ctraabe/BLCtrlToPPM/README.md

# BLCtrlToPWM
University of Tokyo custom board to convert Mikrokopter BLCtrl Commands to typical PWM ESC commands based on ATMega2560
