ctraabe/BLCtrlToPPM/Hardware/BLCtrlToPWM_DigiKey_BOM.xls

Digi-Key品番 | 仕入先 | メーカー品番 | 客先参照品番（任意） | 数量 1 | 数量 2 | 数量 3 | メーカー標準リードタイム | 商品概要 | 注記事項 | RoHS ステータス | 鉛フリーステータス | REACHステータス
S1011EC-40-ND | SULLINS CONNECTOR SOLUTIONS | PRPC040SAAN-RC |  | 1 | 0 | 0 | 3 週間 | CONN HEADER .100" SNGL STR 40POS |  | RoHS対応 | 鉛フリー | 影響なし 6-2016
S2011EC-20-ND | SULLINS CONNECTOR SOLUTIONS (VA) | PRPC020DAAN-RC |  | 1 | 0 | 0 | 4 週間 | CONN HEADER .100" DUAL STR 40POS | 出荷予定日は、未定です。 | RoHS対応 | 鉛フリー | 影響なし 6-2016
ATMEGA2560-16AU-ND | MICROCHIP TECHNOLOGY | ATMEGA2560-16AU | IC1 | 1 | 0 | 0 | 10 週間 | IC MCU 8BIT 256KB FLASH 100TQFP | 他の梱包形態が存在します。 | RoHS対応 | 鉛フリー | 影響なし 12-2015
1276-2605-1-ND | SAMSUNG ELECTRO-MECHANICS AMERICA, INC (VA) | CL21C220JB61PNC | C1,C2 | 2 | 0 | 0 | 17 週間 | CAP CER 22PF 50V NP0 0805 | 他の梱包形態が存在します。 | RoHS対応 | 鉛フリー | 影響なし 6-2016
1276-1090-1-ND | SAMSUNG ELECTRO-MECHANICS AMERICA, INC (VA) | CL21B104JBCNNNC | C3,C4,C5,C6 | 4 | 0 | 0 | 13 週間 | CAP CER 0.1UF 50V X7R 0805 | 他の梱包形態が存在します。 | RoHS対応 | 鉛フリー | 影響なし 6-2016
399-3684-1-ND | KEMET (VA) | T491A106K010AT | C7 | 1 | 0 | 0 | 4 週間 | CAP TANT 10UF 10V 10% 1206 |  | RoHS対応 | 鉛フリー | 影響なし 6-2016
475-1410-1-ND | OSRAM OPTO SEMICONDUCTORS INC(VA) | LG R971-KN-1 | D4 | 1 | 0 | 0 | 8 週間 | LED GREEN DIFFUSED 0805 SMD | 他の梱包形態が存在します。 | RoHS対応 | 鉛フリー | 影響なし 12-2015
475-2560-1-ND | OSRAM OPTO SEMICONDUCTORS INC(VA) | LY R976-PS-36 | D1,D5 | 2 | 0 | 0 | 8 週間 | LED YELLOW DIFFUSED 0805 SMD | 他の梱包形態が存在します。 | RoHS対応 | 鉛フリー | 影響なし 12-2015
475-1415-1-ND | OSRAM OPTO SEMICONDUCTORS INC(VA) | LH R974-LP-1 | D3 | 1 | 0 | 0 | 14 週間 | LED RED DIFFUSED 0805 SMD | 他の梱包形態が存在します。 | RoHS対応 | 鉛フリー | 影響なし 12-2015
732-4982-1-ND | WURTH ELECTRONICS INC (VA) | 150080BS75000 | D2,D6 | 2 | 0 | 0 | 10 週間 | LED BLUE CLEAR 0805 SMD | 他の梱包形態が存在します。 | RoHS対応 | 鉛フリー | 影響なし 6-2016
P10.0KCCT-ND | PANASONIC ELECTRONIC COMPONENTS (VA) | ERJ-6ENF1002V | R1,R9,R10 | 3 | 0 | 0 | 6 週間 | RES SMD 10K OHM 1% 1/8W 0805 | 他の梱包形態が存在します。 | RoHS対応 | 鉛フリー | 影響なし 6-2015
P2.20KCCT-ND | PANASONIC ELECTRONIC COMPONENTS (VA) | ERJ-6ENF2201V | R2,R3,R5,R6 | 4 | 0 | 0 | 6 週間 | RES SMD 2.2K OHM 1% 1/8W 0805 | 他の梱包形態が存在します。 | RoHS対応 | 鉛フリー | 影響なし 6-2015
P1.00KCCT-ND | PANASONIC ELECTRONIC COMPONENTS (VA) | ERJ-6ENF1001V | R4,R7 | 2 | 0 | 0 | 6 週間 | RES SMD 1K OHM 1% 1/8W 0805 | 他の梱包形態が存在します。 | RoHS対応 | 鉛フリー | 影響なし 6-2015
P10849SCT-ND | PANASONIC ELECTRONIC COMPONENTS (VA) | EVQ-PUC02K | SW1 | 1 | 0 | 0 | 6 週間 | SWITCH TACTILE SPST-NO 0.05A 12V | 他の梱包形態が存在します。 | RoHS対応 | 鉛フリー | 影響なし 6-2015
887-1244-ND | TXC CORPORATION | 9B-16.000MEEJ-B | Y1 | 1 | 0 | 0 | 13 週間 | CRYSTAL 16.0000MHZ 18PF T/H |  | RoHS対応 | 鉛フリー | 影響なし 12-2015
BSS138CT-ND | FAIRCHILD SEMICONDUCTOR (VA) | BSS138 | Q1,Q2,Q3,Q4,Q5 | 5 | 0 | 0 | 8 週間 | MOSFET N-CH 50V 220MA SOT-23 | 他の梱包形態が存在します。 | RoHS対応 | 鉛フリー | 影響なし 6-2016
P1.00MCCT-ND | PANASONIC ELECTRONIC COMPONENTS (VA) | ERJ-6ENF1004V | R8 | 1 | 0 | 0 | 6 週間 | RES SMD 1M OHM 1% 1/8W 0805 | 他の梱包形態が存在します。 | RoHS対応 | 鉛フリー | 影響なし 6-2015
