ctraabe/BLCtrlToPPM/Hardware/BLCtrlToPWM.kicad_pcb

## KiCad design Hardware/BLCtrlToPWM.kicad_pcb (2017-01-05)

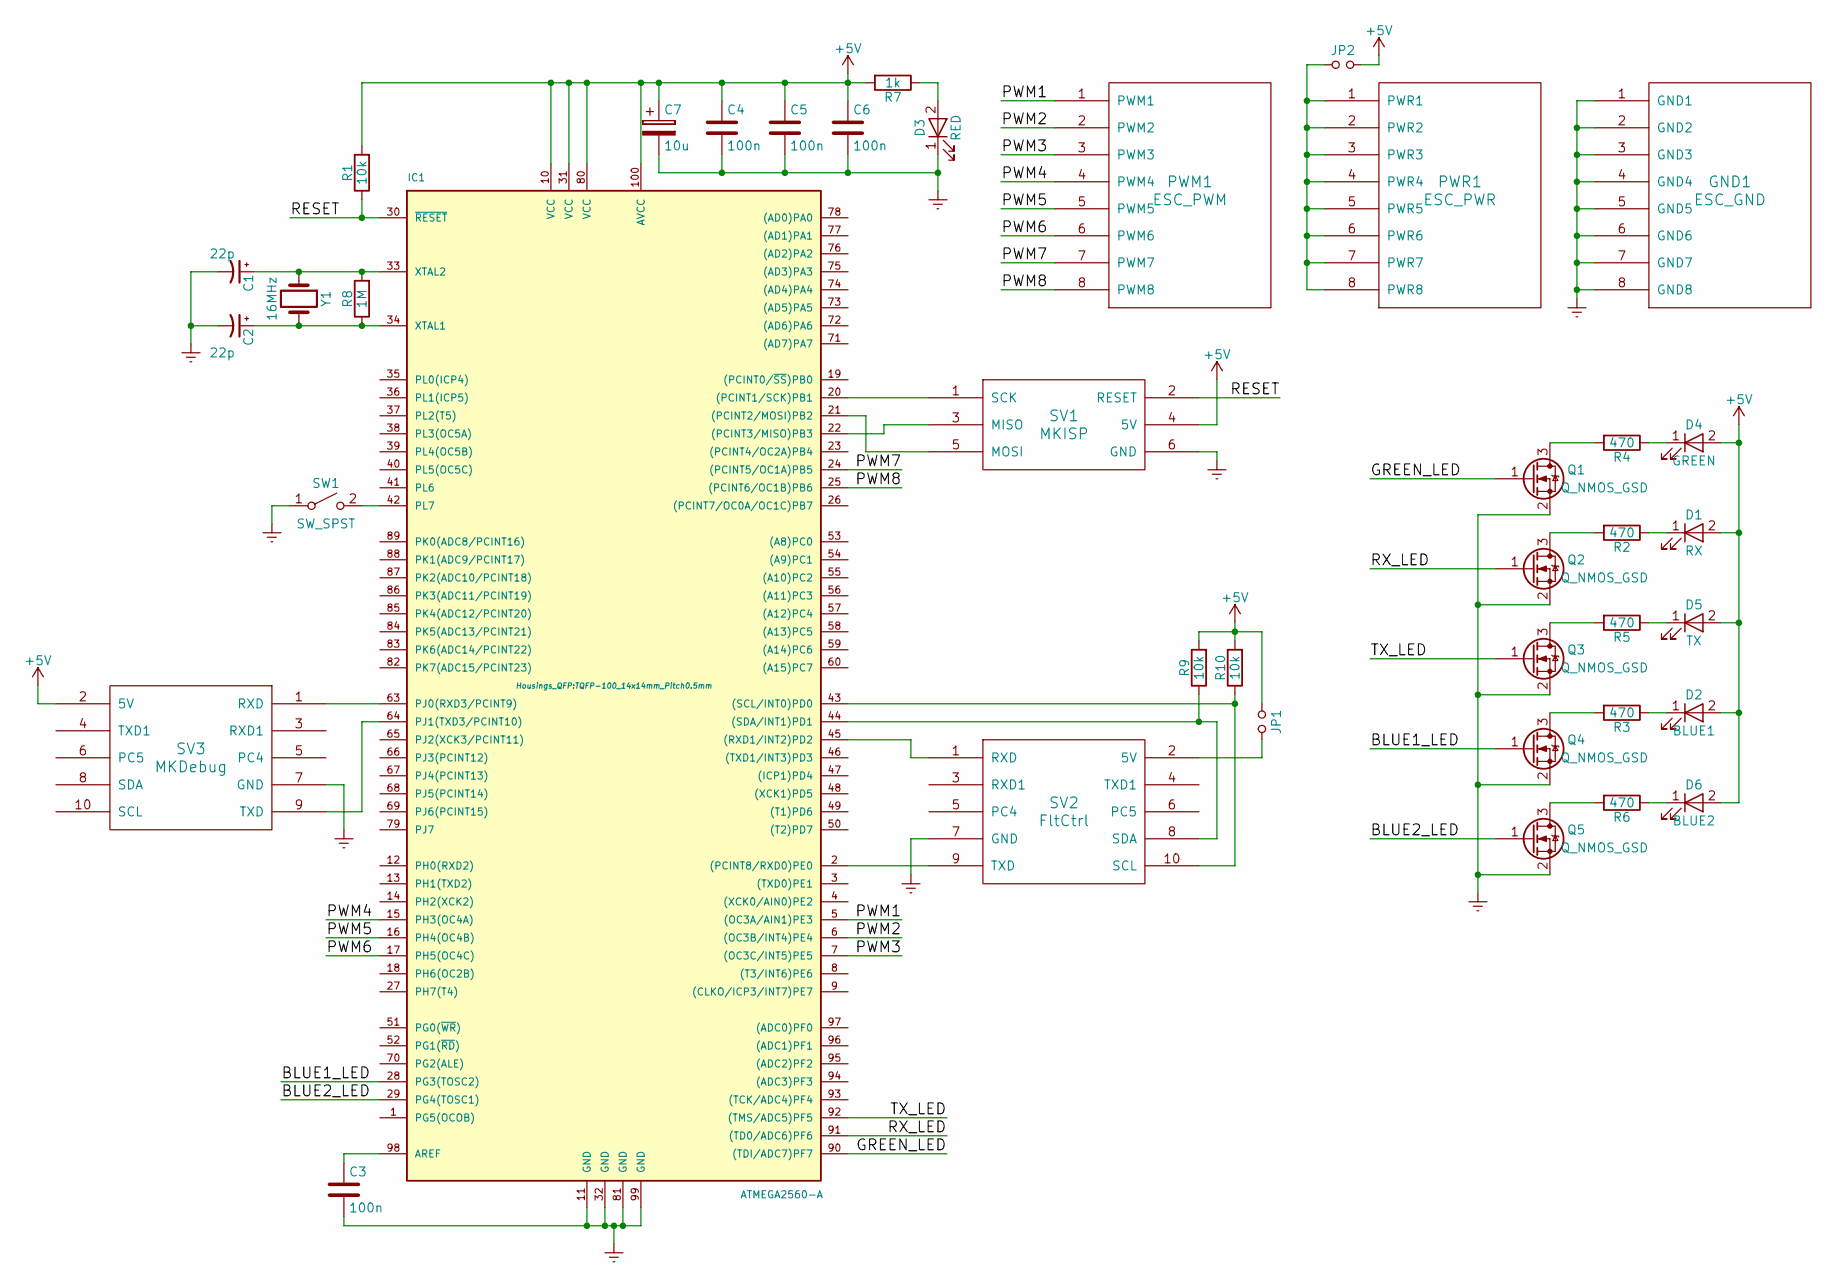
[picture p1: schematic BLCtrlToPWM.sch, BLCtrl Command to PWM Converter]

Parts:
C1, C2: 22p; C_0805_HandSoldering
C3, C4, C5, C6: 100n; C_0805_HandSoldering
C7: 10u; C_1210_HandSoldering
D1: RX; LED-0805
D2: BLUE1; LED-0805
D3: RED; LED-0805
D4: GREEN; LED-0805
D5: TX; LED-0805
D6: BLUE2; LED-0805
GND1: ESC_GND; Pin_Header_Straight_1x08
IC1: ATMEGA2560-A; TQFP-100_14x14mm_Pitch0.5mm
JP1, JP2: Jumper_NO_Small; Pin_Header_Straight_1x02
PWM1: ESC_PWM; Pin_Header_Straight_1x08
PWR1: ESC_PWR; Pin_Header_Straight_1x08
Q1, Q2, Q3, Q4, Q5: Q_NMOS_GSD; SOT-23_Handsoldering
R1, R9, R10: 10k; R_0805_HandSoldering
R2, R3, R4, R5, R6: 470; R_0805_HandSoldering
R7: 1k; R_0805_HandSoldering
R8: 1M; R_0805_HandSoldering
SV1: MKISP; Pin_Header_Edge_2x03
SV2: FltCtrl; Pin_Header_Edge_2x05
SV3: MKDebug; Pin_Header_Edge_2x05
SW1: SW_SPST; PanasonicEVQPU_SPST_NO
Y1: 16MHz; Crystal_HC49-U_Vertical

Connections:
+5V: C4.1, C5.1, C6.1, C7.1, D1.2 (A), D2.2 (A), D4.2 (A), D5.2 (A), D6.2 (A), IC1.10 (VCC), IC1.31 (VCC), IC1.80 (VCC), IC1.100 (AVCC), JP1.1, JP2.2, R1.2, R7.2, R9.2, R10.2, SV1.4 (5V), SV3.2 (5V)
/BLUE1_LED: IC1.28 (PG3(TOSC2)), Q4.1 (G)
/BLUE2_LED: IC1.29 (PG4(TOSC1)), Q5.1 (G)
/GREEN_LED: IC1.90 ((TDI/ADC7)PF7), Q1.1 (G)
/PWM1: IC1.5 ((OC3A/AIN1)PE3), PWM1.1 (PWM1)
/PWM2: IC1.6 ((OC3B/INT4)PE4), PWM1.2 (PWM2)
/PWM3: IC1.7 ((OC3C/INT5)PE5), PWM1.3 (PWM3)
/PWM4: IC1.15 (PH3(OC4A)), PWM1.4 (PWM4)
/PWM5: IC1.16 (PH4(OC4B)), PWM1.5 (PWM5)
/PWM6: IC1.17 (PH5(OC4C)), PWM1.6 (PWM6)
/PWM7: IC1.24 ((PCINT5/OC1A)PB5), PWM1.7 (PWM7)
/PWM8: IC1.25 ((PCINT6/OC1B)PB6), PWM1.8 (PWM8)
/RESET: IC1.30 (~RESET), R1.1, SV1.2 (RESET)
/RX_LED: IC1.91 ((TD0/ADC6)PF6), Q2.1 (G)
/TX_LED: IC1.92 ((TMS/ADC5)PF5), Q3.1 (G)
Earth: C1.2, C2.2, C3.2, C4.2, C5.2, C6.2, C7.2, D3.1 (K), GND1.1 (GND1), GND1.2 (GND2), GND1.3 (GND3), GND1.4 (GND4), GND1.5 (GND5), GND1.6 (GND6), GND1.7 (GND7), GND1.8 (GND8), IC1.11 (GND), IC1.32 (GND), IC1.81 (GND), IC1.99 (GND), Q1.2 (S), Q2.2 (S), Q3.2 (S), Q4.2 (S), Q5.2 (S), SV1.6 (GND), SV2.7 (GND), SV3.7 (GND), SW1.1 (A)
unnamed: C1.1, IC1.33 (XTAL2), R8.2, Y1.1
unnamed: C2.1, IC1.34 (XTAL1), R8.1, Y1.2
unnamed: C3.1, IC1.98 (AREF)
unnamed: D1.1 (K), R2.1
unnamed: D2.1 (K), R3.1
unnamed: D3.2 (A), R7.1
unnamed: D4.1 (K), R4.1
unnamed: D5.1 (K), R5.1
unnamed: D6.1 (K), R6.1
unnamed: IC1.2 ((PCINT8/RXD0)PE0), SV2.9 (TXD)
unnamed: IC1.20 ((PCINT1/SCK)PB1), SV1.1 (SCK)
unnamed: IC1.21 ((PCINT2/MOSI)PB2), SV1.5 (MOSI)
unnamed: IC1.22 ((PCINT3/MISO)PB3), SV1.3 (MISO)
unnamed: IC1.42 (PL7), SW1.2 (B)
unnamed: IC1.43 ((SCL/INT0)PD0), R10.1, SV2.10 (SCL)
unnamed: IC1.44 ((SDA/INT1)PD1), R9.1, SV2.8 (SDA)
unnamed: IC1.45 ((RXD1/INT2)PD2), SV2.1 (RXD)
unnamed: IC1.63 (PJ0(RXD3/PCINT9)), SV3.1 (RXD)
unnamed: IC1.64 (PJ1(TXD3/PCINT10)), SV3.9 (TXD)
unnamed: JP1.2, SV2.2 (5V)
unnamed: JP2.1, PWR1.1 (PWR1), PWR1.2 (PWR2), PWR1.3 (PWR3), PWR1.4 (PWR4), PWR1.5 (PWR5), PWR1.6 (PWR6), PWR1.7 (PWR7), PWR1.8 (PWR8)
unnamed: Q1.3 (D), R4.2
unnamed: Q2.3 (D), R2.2
unnamed: Q3.3 (D), R5.2
unnamed: Q4.3 (D), R3.2
unnamed: Q5.3 (D), R6.2

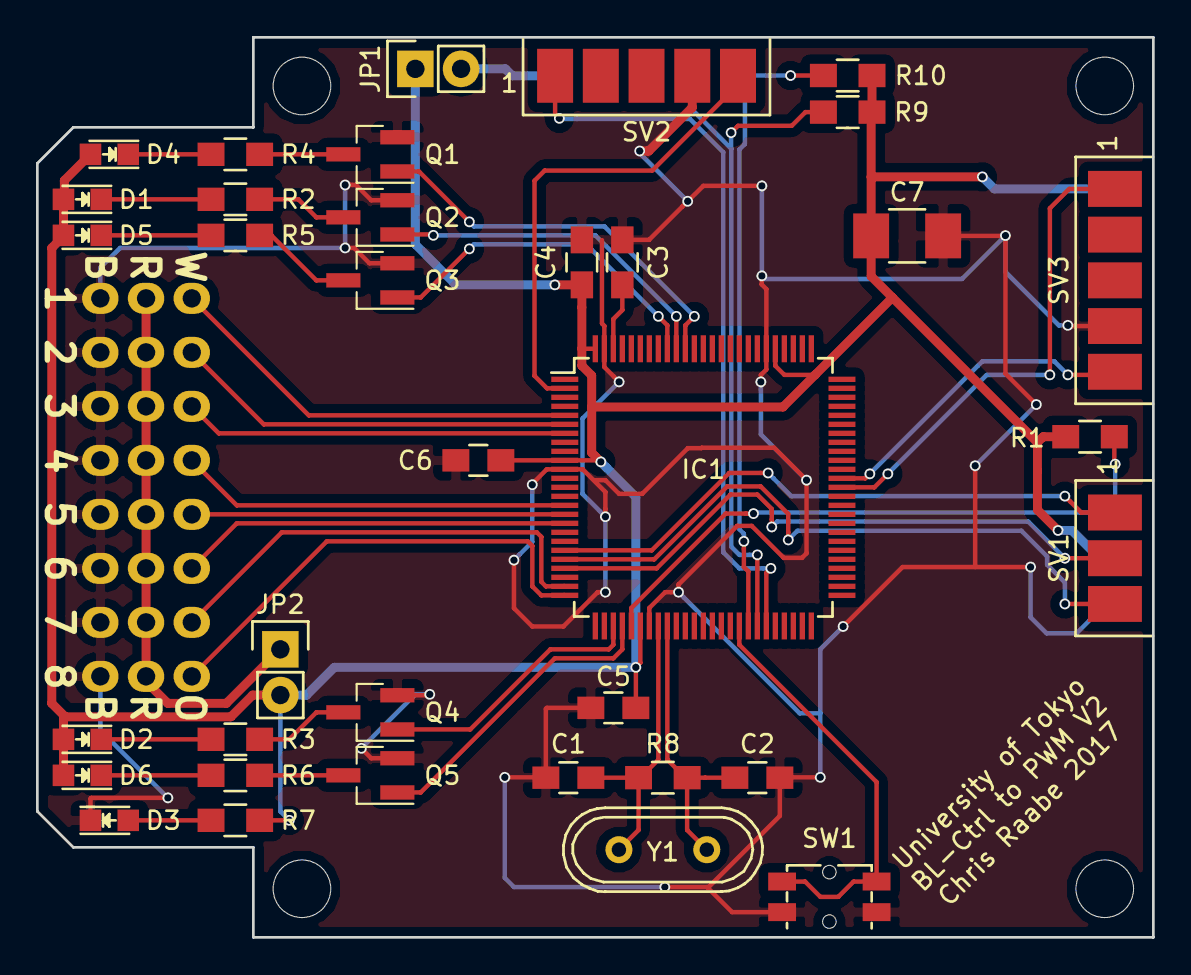
[picture p2: board BLCtrlToPWM.kicad_pcb from above]

Board: 2 copper layers, 62.0 x 50.0 mm, 39 parts (0 on the bottom side), 42 nets.
