ctraabe/BLCtrlToPPM/led.h

#ifndef LED_H_
#define LED_H_


// =============================================================================
// Public functions:

void LEDInit(void);

// -----------------------------------------------------------------------------
void BlueLED1Off(void);

// -----------------------------------------------------------------------------
void BlueLED1On(void);

// -----------------------------------------------------------------------------
void BlueLED1Toggle(void);

// -----------------------------------------------------------------------------
void BlueLED2Off(void);

// -----------------------------------------------------------------------------
void BlueLED2On(void);

// -----------------------------------------------------------------------------
void BlueLED2Toggle(void);

// -----------------------------------------------------------------------------
void GreenLEDOff(void);

// -----------------------------------------------------------------------------
void GreenLEDOn(void);

// -----------------------------------------------------------------------------
void GreenLEDToggle(void);

// -----------------------------------------------------------------------------
void YellowLED1Off(void);

// -----------------------------------------------------------------------------
void YellowLED1On(void);

// -----------------------------------------------------------------------------
void YellowLED1Toggle(void);

// -----------------------------------------------------------------------------
void YellowLED2Off(void);

// -----------------------------------------------------------------------------
void YellowLED2On(void);

// -----------------------------------------------------------------------------
void YellowLED2Toggle(void);


#endif  // LED_H_
