ctraabe/BLCtrlToPPM/(commit log)

2015-10-30 Modified the handling of Arduino pins
2015-10-30 Added framework for PWM output. TODO: Add functions to change pulse widths from 1.1 ms to 1.94 ms.
2015-11-02 Added framework for setting individual PPM channels from 0 to 1680 (TIMER4 only)
2015-11-06 Updated arduino header to allow setting of pin modes.
2015-11-06 Added uart
2015-11-08 First attempt at adding BLCtrl command reception. Should probably just put all i2c AND blctrl protocol stuff in the same file since it won't be doing anything else.
    [i2c.c, i2c.h, main.c]
2015-11-16 Adapted code to new custom board. It works!
2016-02-03 Fixed i2c addressing error
    [i2c.c, ppm.c]
2016-02-03 Removed UART due to interference with other comms (need to be fixed in next board revision)
    [main.c]
2016-11-17 Changed mistaken references to PPM to PWM (non-functional change)
    [main.c, pwm.c, pwm.h]
2016-11-17 Added board design files to the repository
    [BLCtrlToPWM-B_Cu.gbr, BLCtrlToPWM-B_Mask.gbr, BLCtrlToPWM-B_SilkS.gbr, BLCtrlToPWM-Edge_Cuts.gbr, BLCtrlToPWM-F_Cu.gbr, BLCtrlToPWM-F_Mask.gbr, BLCtrlToPWM-F_SilkS.gbr, BLCtrlToPWM-NPTH.drl]
2016-11-17 Added MikroKopter KiCad library as a submodule
2016-12-15 Added second debug serial output. Changed TX on existing serial linesto RX. Added N-MOSFETs to LEDs to remove current requrements on MCU. Added jumpers for power source selection (preferably use the 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
    [BLCtrlToPWM.sch]
2016-12-17 Added common KiCad library
2016-12-17 Updated KiCadCommon submodule (with corrected edge pin header solder mask layers)
2016-12-17 Updated board layout with new components, but they are yet to be placed and traces need to be added
    [BLCtrlToPWM.kicad_pcb]
2016-12-17 Updated gerber files to match new KiCad standard naming convention
    [BLCtrlToPWM-B.Cu.gbr, BLCtrlToPWM-B.Mask.gbr, BLCtrlToPWM-B.SilkS.gbr, BLCtrlToPWM-B_Cu.gbr, BLCtrlToPWM-B_Mask.gbr, BLCtrlToPWM-B_SilkS.gbr, BLCtrlToPWM-Edge.Cuts.gbr, BLCtrlToPWM-Edge_Cuts.gbr]
2016-12-17 Widened the gap between ESC headers
    [BLCtrlToPWM.kicad_pcb]
2016-12-27 Small progress on board layout
    [BLCtrlToPWM.kicad_pcb]
2017-01-04 Finished board design for version 2
    [BLCtrlToPWM-B.Cu.gbr, BLCtrlToPWM-B.Mask.gbr, BLCtrlToPWM-B.SilkS.gbr, BLCtrlToPWM-Edge.Cuts.gbr, BLCtrlToPWM-F.Cu.gbr, BLCtrlToPWM-F.Mask.gbr, BLCtrlToPWM-F.SilkS.gbr, BLCtrlToPWM-NPTH.drl]
2017-01-05 Updated common library submodule (now includes side button)
2017-01-05 Added a side button
    [BLCtrlToPWM-B.Cu.gbr, BLCtrlToPWM-B.Mask.gbr, BLCtrlToPWM-B.SilkS.gbr, BLCtrlToPWM-Edge.Cuts.gbr, BLCtrlToPWM-F.Cu.gbr, BLCtrlToPWM-F.Mask.gbr, BLCtrlToPWM-F.SilkS.gbr, BLCtrlToPWM-NPTH.drl]
2017-01-05 Added files for Elecrow PCB order
    [BLCtrlToPWM.GBL, BLCtrlToPWM.GBO, BLCtrlToPWM.GBS, BLCtrlToPWM.GTL, BLCtrlToPWM.GTO, BLCtrlToPWM.GTS]
2017-01-19 Removed rescue library
    [BLCtrlToPWM.sch]
2017-01-26 Added DigiKey BOM file for V2
    [BLCtrlToPWM_DigiKey_BOM.xls]
2017-01-29 Updated resistor values and BOM
    [BLCtrlToPWM.sch, BLCtrlToPWM_DigiKey_BOM.xls]
2017-02-24 Reinstated UART on new header
2017-02-24 Attempt to fix 12-bit motor commands
    [i2c.c]
2017-02-25 Updated I2C logic to include TX indicator
